MTubbin/ECE212-telemetry-tracker/hardware/ESP32_Tracker.kicad_pcb

## KiCad design hardware/ESP32_Tracker.kicad_pcb (2026-01-22)

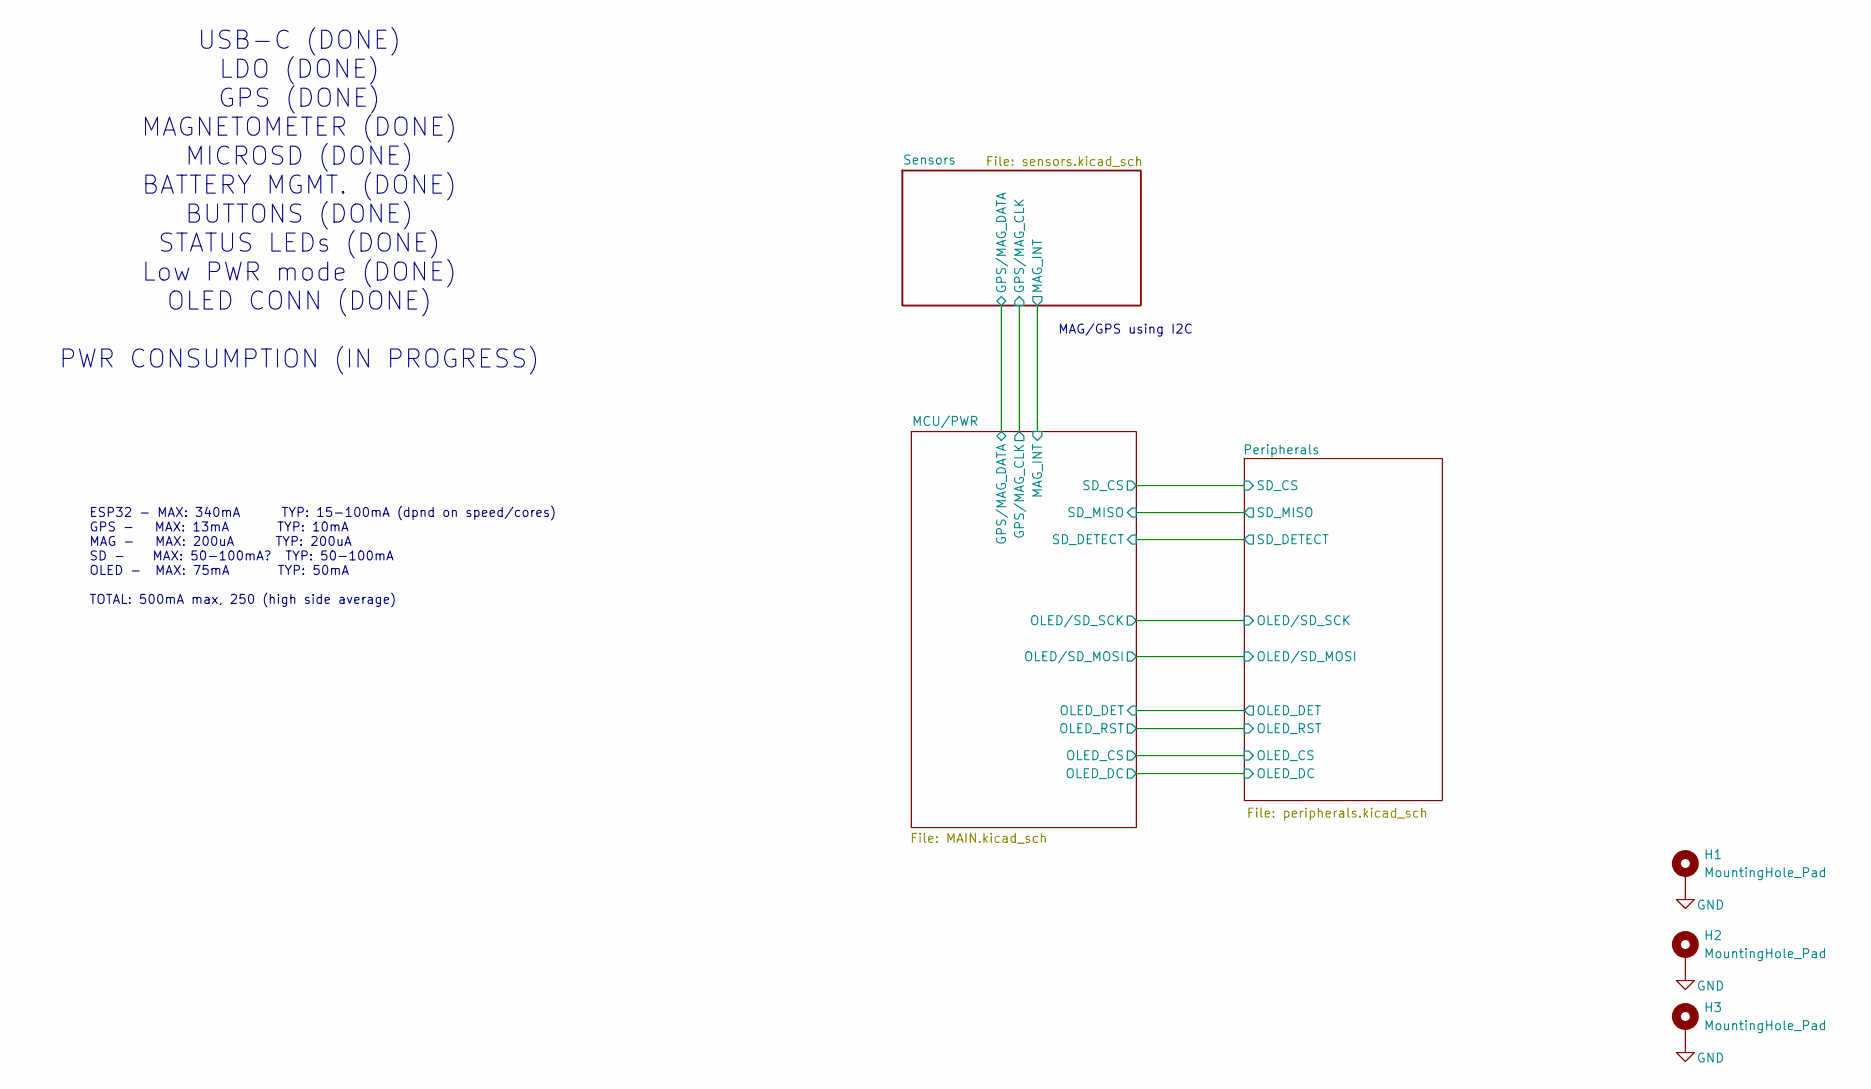
[picture p1: schematic ESP32_Tracker.kicad_sch, ESP32 Telemetry Tracker Board]

Parts:
H1, H2, H3: MountingHole_Pad; MountingHole_2.2mm_M2_Pad_Via

Connections:
GND: H1.1, H2.1, H3.1; also elsewhere on the board

Notes on the sheet:
USB-C (DONE) LDO (DONE) GPS (DONE) MAGNETOMETER (DONE) MICROSD (DONE) BATTERY MGMT. (DONE) BUTTONS (DONE) STATUS LEDs (DONE) Low PWR mode (DONE) OLED CONN (DONE) PWR CONSUMPTION (IN PROGRESS)
MAG/GPS using I2C
ESP32 - MAX: 340mA TYP: 15-100mA (dpnd on speed/cores) GPS - MAX: 13mA TYP: 10mA MAG - MAX: 200uA TYP: 200uA SD - MAX: 50-100mA? TYP: 50-100mA OLED - MAX: 75mA TYP: 50mA TOTAL: 500mA max, 250 (high side average)

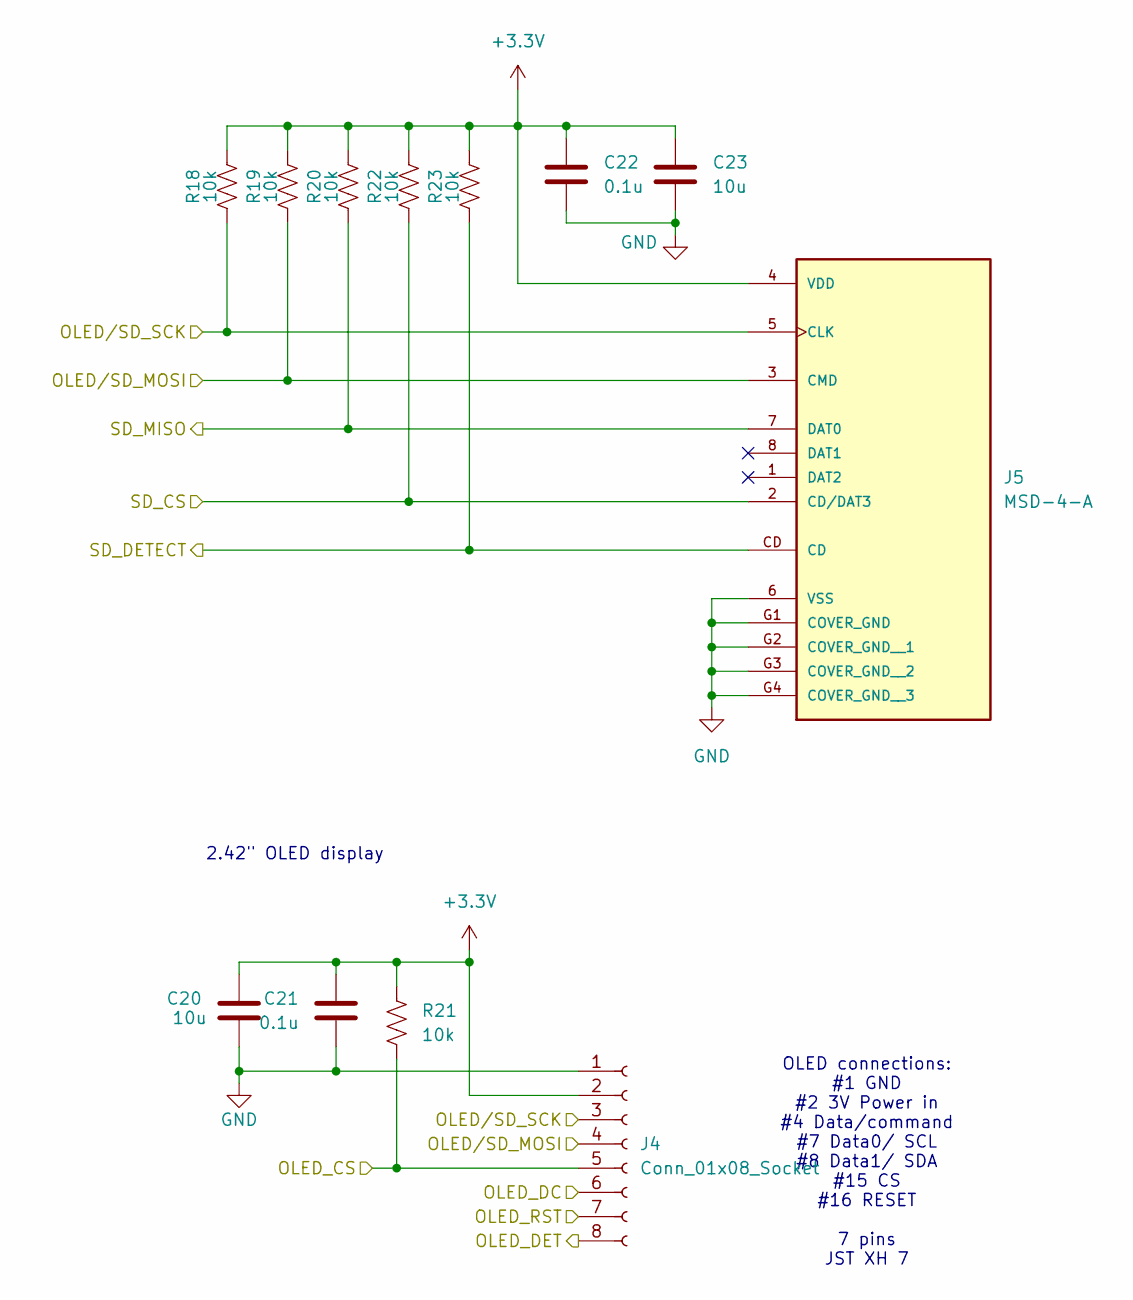
[picture p2: schematic peripherals.kicad_sch]

Parts:
C20, C23: 10u; C_0805_2012Metric; MPN CL21B106KOQNNNE; LCSC C95841
C21, C22: 0.1u; C_0805_2012Metric; MPN CL21B104KBCNNNC; LCSC C519980
J4: Conn_01x08_Socket; JST_PH_S8B-PH-K_1x08_P2.00mm_Horizontal; MPN S8B-PH-K-S
J5: MSD-4-A; CUI_MSD-4-A; PARTREV 1.0
R18, R19, R20, R21, R22, R23: 10k; R_0805_2012Metric; MPN RC0805JR-0710KL; LCSC C17414

Connections:
+3.3V: C20.2, C21.1, C22.1, C23.1, J4.2, J5.4 (VDD), R18.1, R19.1, R20.1, R21.2, R22.1, R23.1; also elsewhere on the board
/MCU/PWR/OLED_CS: J4.5, R21.1; also elsewhere on the board
/MCU/PWR/OLED_DC: J4.6; also elsewhere on the board
/MCU/PWR/OLED_DET: J4.8; also elsewhere on the board
/MCU/PWR/OLED_RST: J4.7; also elsewhere on the board
/MCU/PWR/OLED/SD_MOSI: J4.4, J5.3 (CMD), R19.2; also elsewhere on the board
/MCU/PWR/OLED/SD_SCK: J4.3, J5.5 (CLK), R18.2; also elsewhere on the board
/MCU/PWR/SD_CS: J5.2 (CD/DAT3), R22.2; also elsewhere on the board
/MCU/PWR/SD_DETECT: J5.CD, R23.2; also elsewhere on the board
/MCU/PWR/SD_MISO: J5.7 (DAT0), R20.2; also elsewhere on the board
GND: C20.1, C21.2, C22.2, C23.2, J4.1, J5.6 (VSS), J5.G1 (COVER_GND), J5.G2 (COVER_GND__1), J5.G3 (COVER_GND__2), J5.G4 (COVER_GND__3); also elsewhere on the board

Notes on the sheet:
2.42" OLED display
OLED connections: #1 GND #2 3V Power in #4 Data/command #7 Data0/ SCL #8 Data1/ SDA #15 CS #16 RESET 7 pins JST XH 7

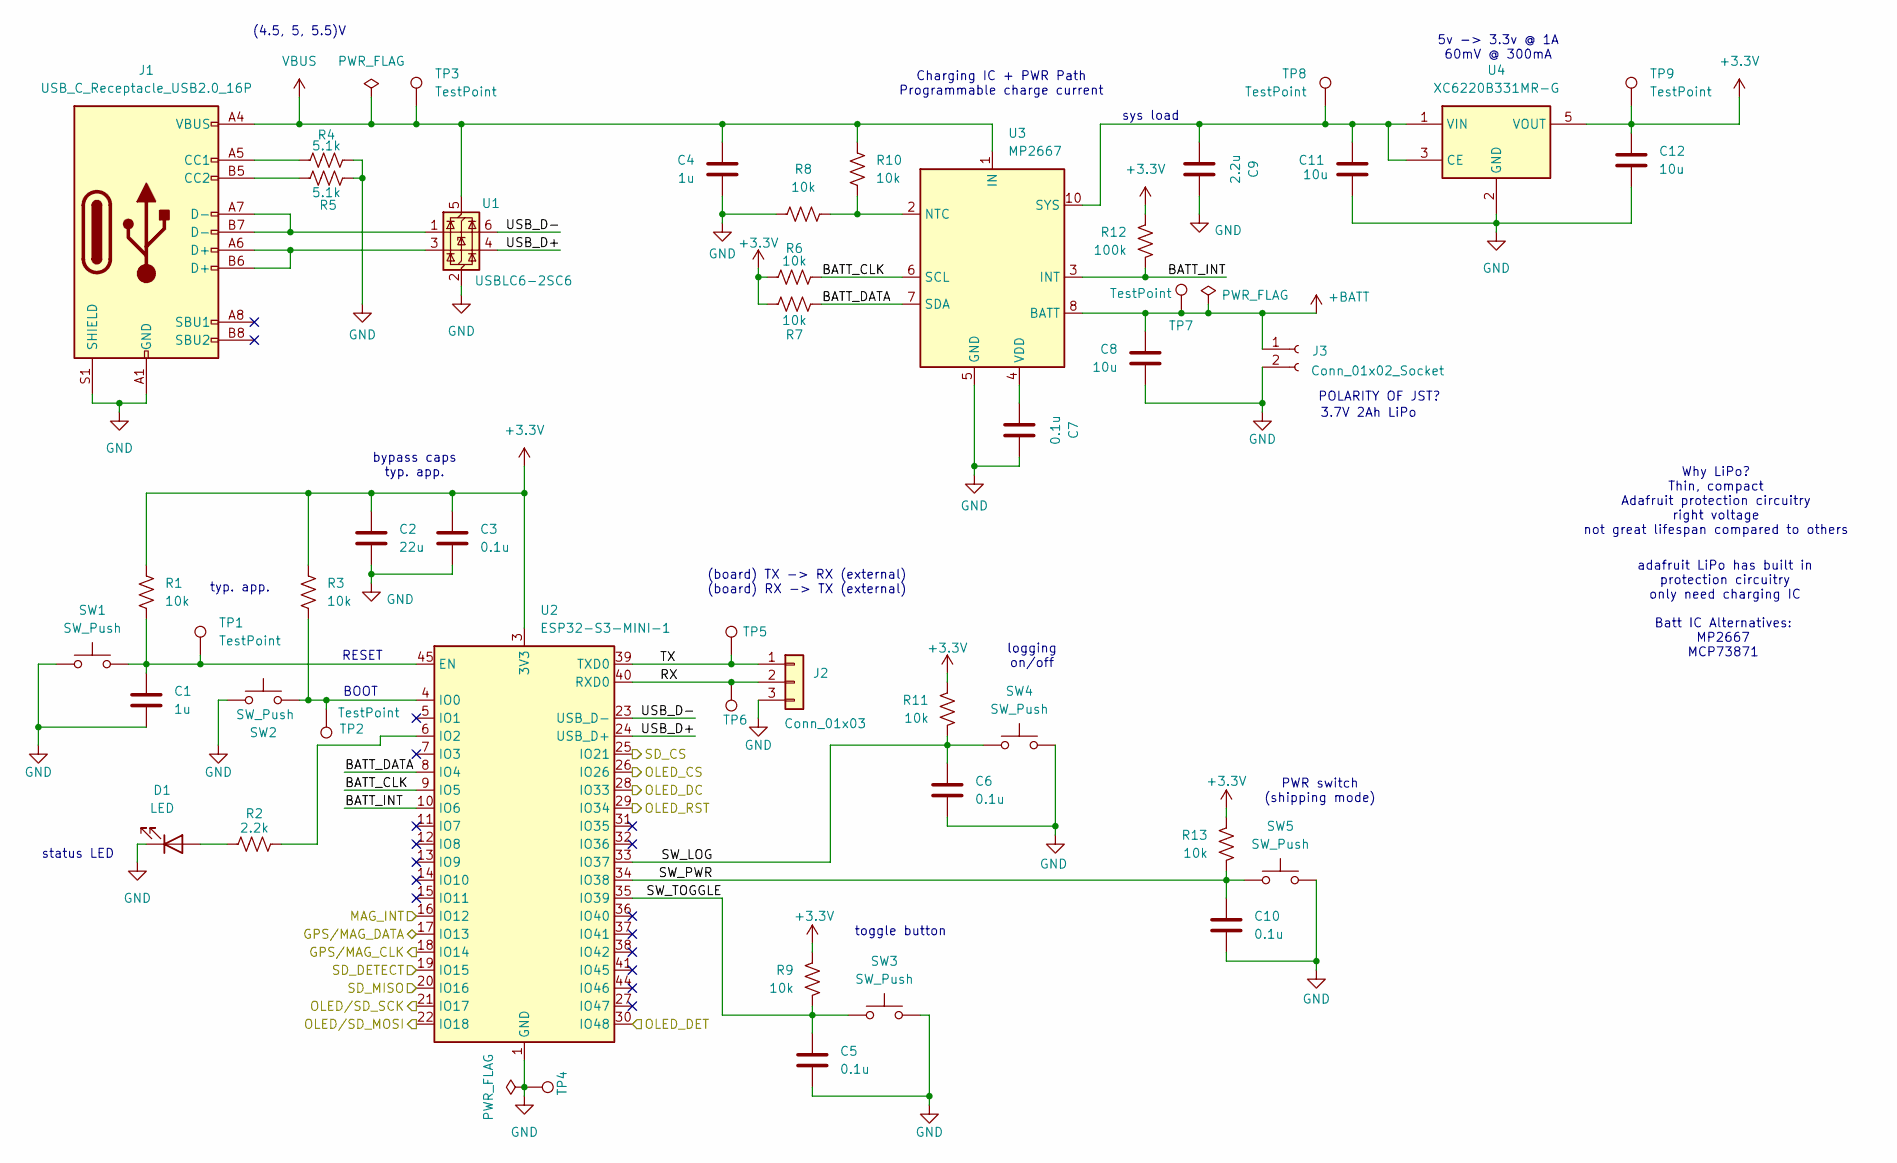
[picture p3: schematic MAIN.kicad_sch]

Parts:
C1, C4: 1u; C_0805_2012Metric; MPN CL21B105KOFNNWE; LCSC C24123
C2: 22u; C_0805_2012Metric; MPN CL21A226MOCLRNC; LCSC C98190
C3, C5, C6, C7, C10: 0.1u; C_0805_2012Metric; MPN CL21B104KBCNNNC; LCSC C519980
C8, C11, C12: 10u; C_0805_2012Metric; MPN CL21B106KOQNNNE; LCSC C95841
C9: 2.2u; C_0805_2012Metric; MPN CL21B225KOFNNNE; LCSC C28234
D1: LED; LED_0805_2012Metric; MPN LTST-C170GKT; LCSC C965812
J1: USB_C_Receptacle_USB2.0_16P; USB_C_Receptacle_GCT_USB4105-xx-A_16P_TopMnt_Horizontal; MPN USB4105-GF-A
J2: Conn_01x03; PinHeader_1x03_P2.54mm_Vertical
J3: Conn_01x02_Socket; JST_PH_S2B-PH-K_1x02_P2.00mm_Horizontal
R1, R3, R6, R7, R8, R9, R10, R11, R13: 10k; R_0805_2012Metric; MPN RC0805JR-0710KL; LCSC C17414
R2: 2.2k; R_0805_2012Metric; MPN RC0805FR-072K2L; LCSC C17520
R4, R5: 5.1k; R_0805_2012Metric; MPN RC0805JR-075K1L; LCSC C27834
R12: 100k; R_0805_2012Metric; MPN RC0805FR-07100KL; LCSC C149504
SW1, SW2: SW_Push; SW_SPST_B3U-1000P; MPN B3U-1000P; LCSC C720477
SW3, SW4, SW5: SW_Push; SW_SPST_TL3305C; MPN TL3305CF260QG
TP1, TP2, TP3, TP4, TP5, TP6, TP7, TP8, TP9: TestPoint; TestPoint_Pad_D1.5mm
U1: USBLC6-2SC6; SOT-23-6; MPN USBLC6-2SC6; LCSC C2827654
U2: ESP32-S3-MINI-1; ESP32-S2-MINI-1; MPN ESP32-S3-MINI-1-N8; LCSC C2913206
U3: MP2667; QFN-10_2MMx2MM_MNP; MPN MP2667GG-0000-Z
U4: XC6220B331MR-G; SOT-23-5; MPN XC6220B331MR-G; LCSC C86534

Connections:
+3.3V: C2.1, C3.1, C12.1, R1.2, R3.2, R6.2, R7.1, R9.2, R11.2, R12.1, R13.2, TP9.1, U2.3 (3V3), U4.5 (VOUT); also elsewhere on the board
+BATT: C8.2, J3.1, TP7.1, U3.8 (BATT), U3.9 (BATT)
/MCU/PWR/BATT_CLK: R6.1, U2.9 (IO5), U3.6 (SCL)
/MCU/PWR/BATT_DATA: R7.2, U2.8 (IO4), U3.7 (SDA)
/MCU/PWR/BATT_INT: R12.2, U2.10 (IO6), U3.3 (INT)
/MCU/PWR/GPS/MAG_CLK: U2.18 (IO14); also elsewhere on the board
/MCU/PWR/GPS/MAG_DATA: U2.17 (IO13); also elsewhere on the board
/MCU/PWR/MAG_INT: U2.16 (IO12); also elsewhere on the board
/MCU/PWR/OLED_CS: U2.26 (IO26); also elsewhere on the board
/MCU/PWR/OLED_DC: U2.28 (IO33); also elsewhere on the board
/MCU/PWR/OLED_DET: U2.30 (IO48); also elsewhere on the board
/MCU/PWR/OLED_RST: U2.29 (IO34); also elsewhere on the board
/MCU/PWR/OLED/SD_MOSI: U2.22 (IO18); also elsewhere on the board
/MCU/PWR/OLED/SD_SCK: U2.21 (IO17); also elsewhere on the board
/MCU/PWR/RX: J2.2, TP6.1, U2.40 (RXD0)
/MCU/PWR/SD_CS: U2.25 (IO21); also elsewhere on the board
/MCU/PWR/SD_DETECT: U2.19 (IO15); also elsewhere on the board
/MCU/PWR/SD_MISO: U2.20 (IO16); also elsewhere on the board
/MCU/PWR/SW_LOG: C6.1, R11.1, SW4.1, U2.33 (IO37)
/MCU/PWR/SW_PWR: C10.1, R13.1, SW5.1, U2.34 (IO38)
/MCU/PWR/SW_TOGGLE: C5.1, R9.1, SW3.2, U2.35 (IO39)
/MCU/PWR/TX: J2.1, TP5.1, U2.39 (TXD0)
/MCU/PWR/USB_D+: U1.4 (I/O2), U2.24 (USB_D+)
/MCU/PWR/USB_D-: U1.6 (I/O1), U2.23 (USB_D-)
GND: C1.2, C2.2, C3.2, C4.1, C5.2, C6.2, C7.2, C8.1, C9.2, C10.2, C11.1, C12.2, D1.1 (K), J1.A1 (GND), J1.A12 (GND), J1.B1 (GND), J1.B12 (GND), J1.S1 (SHIELD), J2.3, J3.2, R4.1, R5.2, R8.2, SW1.1, SW2.2, SW3.1, SW4.2, SW5.2, TP4.1, U1.2 (GND), U2.1 (GND), U2.2 (GND), U2.42 (GND), U2.43 (GND), U2.46 (GND), U2.47 (GND), U2.48 (GND), U2.49 (GND), U2.50 (GND), U2.51 (GND), U2.52 (GND), U2.53 (GND), U2.54 (GND), U2.55 (GND), U2.56 (GND), U2.57 (GND), U2.58 (GND), U2.59 (GND), U2.60 (GND), U2.61 (GND), U2.62 (GND), U2.63 (GND), U2.64 (GND), U2.65 (GND), U3.5 (GND), U4.2 (GND); also elsewhere on the board
unnamed: D1.2 (A), R2.2
unnamed: J1.A5 (CC1), R4.2
unnamed: J1.B5 (CC2), R5.1
unnamed: J1.A6 (D+), J1.B6 (D+), U1.3 (I/O2)
unnamed: J1.A7 (D-), J1.B7 (D-), U1.1 (I/O1)
unnamed: C1.1, R1.1, SW1.2, TP1.1, U2.45 (EN)
unnamed: R3.1, SW2.1, TP2.1, U2.4 (IO0)
unnamed: R2.1, U2.6 (IO2)
unnamed: R8.1, R10.1, U3.2 (NTC)
unnamed: C9.1, C11.2, TP8.1, U3.10 (SYS), U4.1 (VIN), U4.3 (CE)
unnamed: C7.1, U3.4 (VDD)
VBUS: C4.2, J1.A4 (VBUS), J1.A9 (VBUS), J1.B4 (VBUS), J1.B9 (VBUS), R10.2, TP3.1, U1.5 (VBUS), U3.1 (IN)

Notes on the sheet:
PWR switch (shipping mode)
BOOT
RESET
3.7V 2Ah LiPo
5v -> 3.3v @ 1A 60mV @ 300mA
Charging IC + PWR Path Programmable charge current
(4.5, 5, 5.5)V
Why LiPo? Thin, compact Adafruit protection circuitry right voltage not great lifespan compared to others
Batt IC Alternatives: MP2667 MCP73871
toggle button
logging on/off
bypass caps typ. app.
(board) TX -> RX (external) (board) RX -> TX (external)
POLARITY OF JST?
status LED
adafruit LiPo has built in protection circuitry only need charging IC
sys load
typ. app.

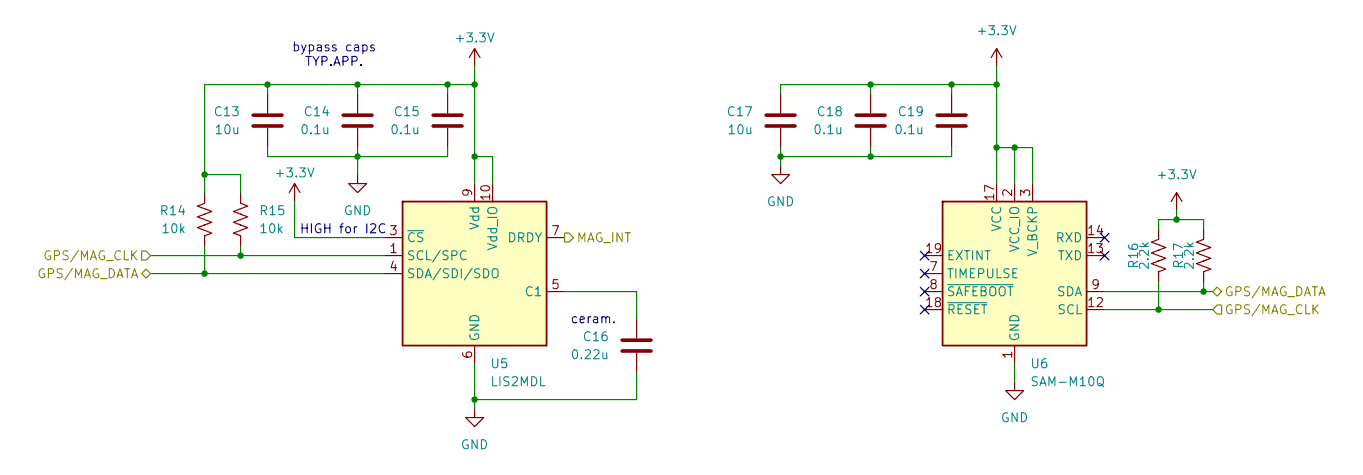
[picture p4: schematic sensors.kicad_sch]

Parts:
C13, C17: 10u; C_0805_2012Metric; MPN CL21B106KOQNNNE; LCSC C95841
C14, C15, C18, C19: 0.1u; C_0805_2012Metric; MPN CL21B104KBCNNNC; LCSC C519980
C16: 0.22u; C_0805_2012Metric; MPN CL21B224KAFNNNE; LCSC C113853
R14, R15: 10k; R_0805_2012Metric; MPN RC0805JR-0710KL; LCSC C17414
R16, R17: 2.2k; R_0805_2012Metric; MPN RC0805FR-072K2L; LCSC C17520
U5: LIS2MDL; LGA-12_2x2mm_P0.5mm; MPN LIS2MDLTR
U6: SAM-M10Q; ublox_SAM-M8Q; MPN SAM-M10Q-00B

Connections:
+3.3V: C13.1, C14.1, C15.1, C17.1, C18.1, C19.1, R14.2, R15.2, R16.2, R17.2, U5.3 (~CS), U5.9 (Vdd), U5.10 (Vdd_IO), U6.2 (VCC_IO), U6.3 (V_BCKP), U6.17 (VCC); also elsewhere on the board
/MCU/PWR/GPS/MAG_CLK: R15.1, R16.1, U5.1 (SCL/SPC), U6.12 (SCL); also elsewhere on the board
/MCU/PWR/GPS/MAG_DATA: R14.1, R17.1, U5.4 (SDA/SDI/SDO), U6.9 (SDA); also elsewhere on the board
/MCU/PWR/MAG_INT: U5.7 (DRDY); also elsewhere on the board
GND: C13.2, C14.2, C15.2, C16.2, C17.2, C18.2, C19.2, U5.6 (GND), U5.8 (GND), U6.1 (GND), U6.4 (GND), U6.5 (GND), U6.6 (GND), U6.10 (GND), U6.11 (GND), U6.15 (GND), U6.16 (GND), U6.20 (GND); also elsewhere on the board
unnamed: C16.1, U5.5 (C1)

Notes on the sheet:
ceram.
HIGH for I2C
bypass caps TYP.APP.

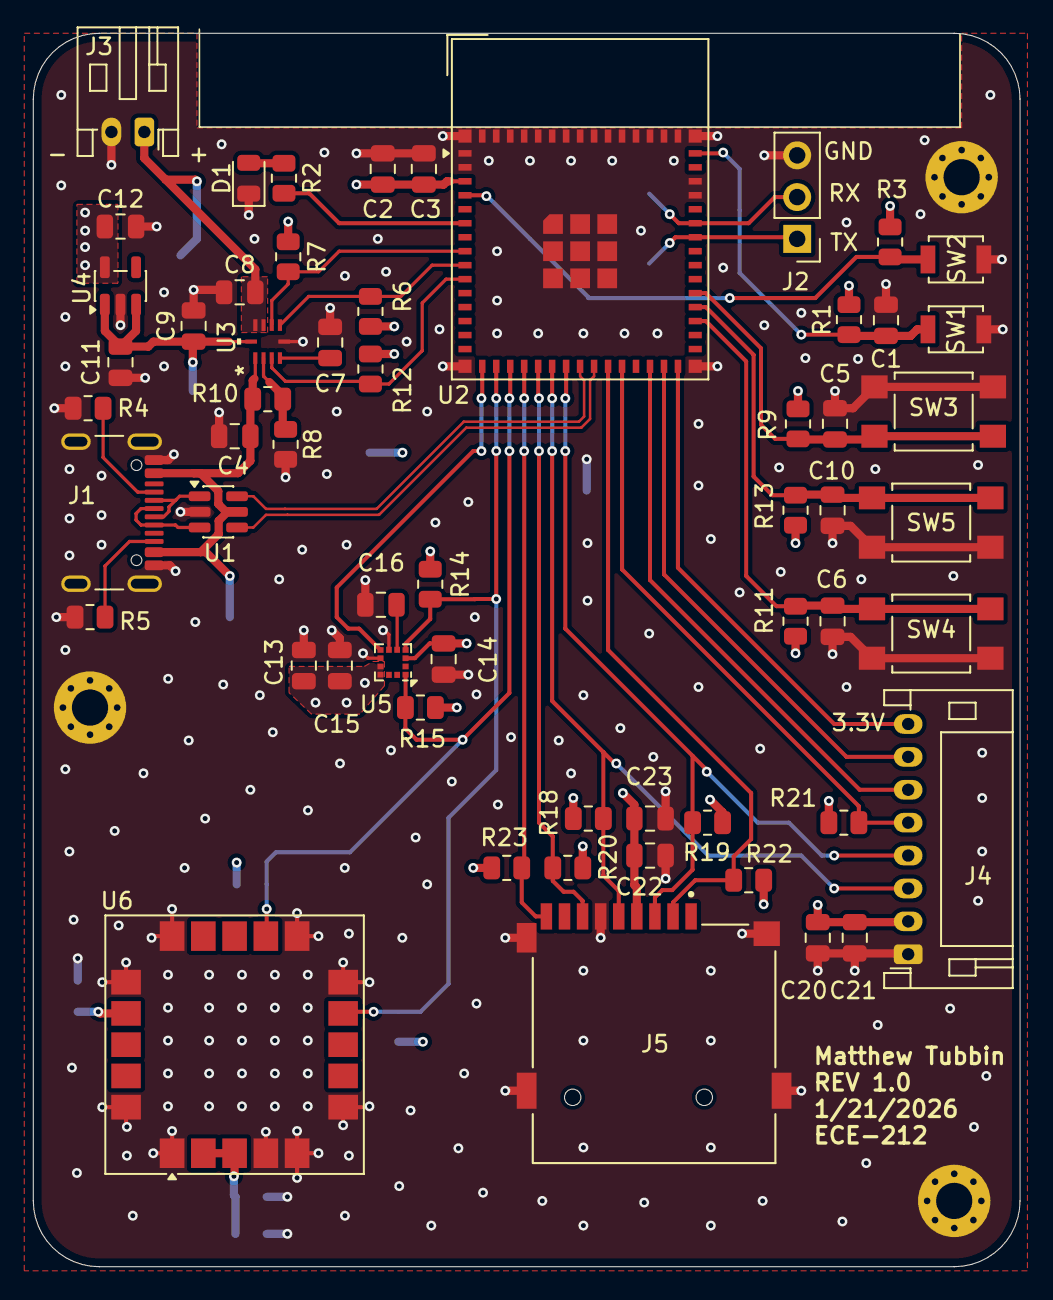
[picture p5: board ESP32_Tracker.kicad_pcb from above]

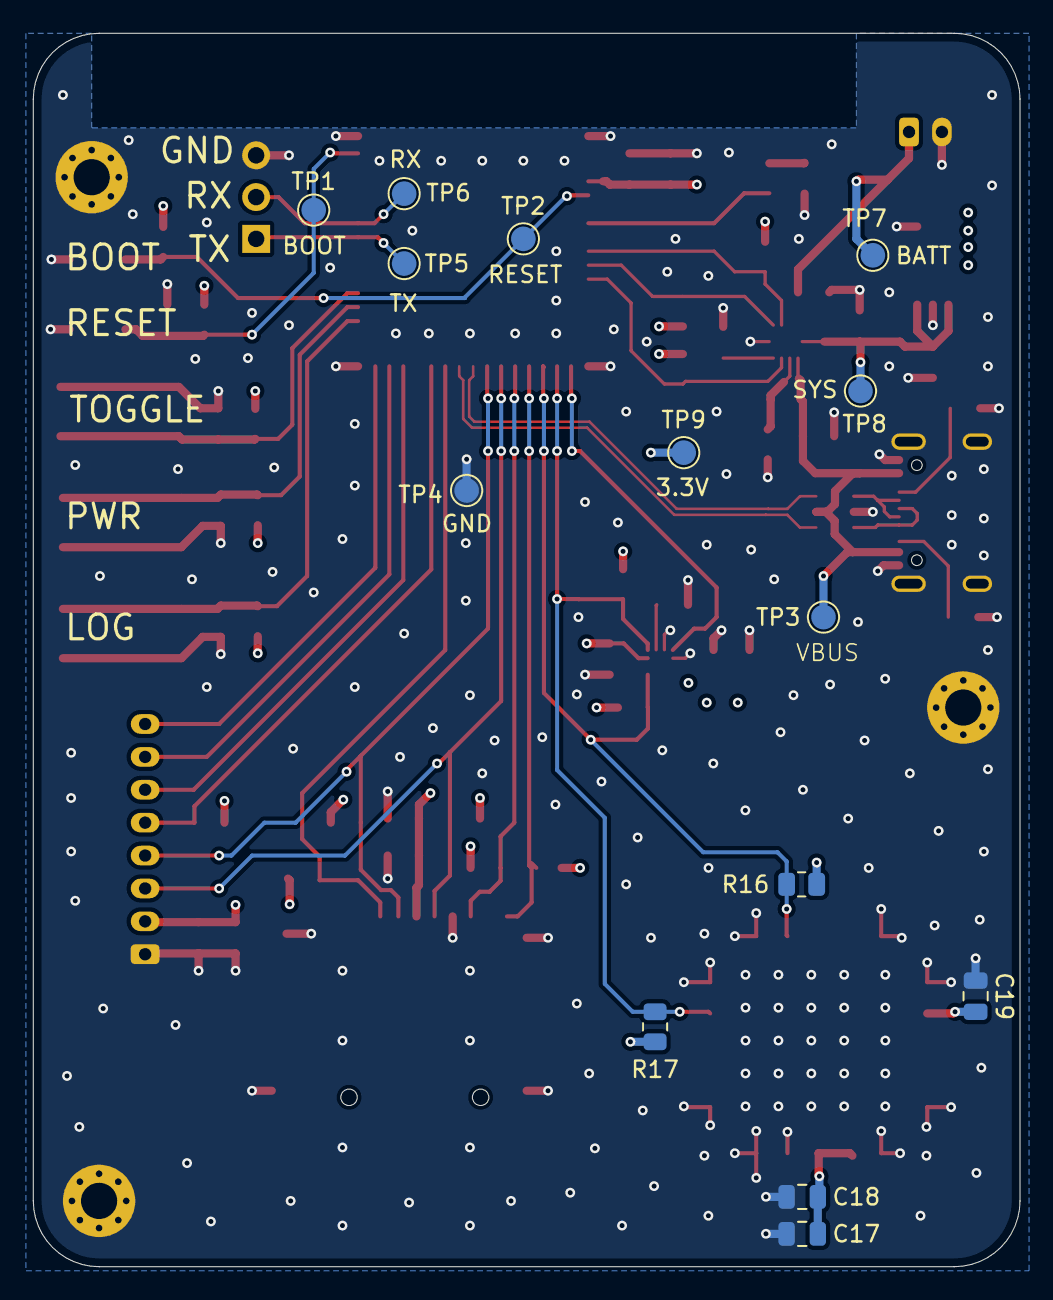
[picture p6: board ESP32_Tracker.kicad_pcb from below]

Board: 4 copper layers, 60.0 x 75.0 mm, 75 parts (14 on the bottom side), 38 nets.
