MTubbin/ECE212-telemetry-tracker/(commit log)

2026-01-07 kicad files added
    [ESP32_Tracker.kicad_pcb, ESP32_Tracker.kicad_sch]
2026-01-08 initial schematic started
    [ESP32_Tracker.kicad_sch]
2026-01-08 magnt. symbol created
    [ESP32_Tracker.kicad_sch]
2026-01-09 new magnetometer
    [ESP32_Tracker.kicad_sch]
2026-01-11 initial schematic completed
    [ESP32_Tracker.kicad_sch]
2026-01-11 MP Footprint created
    [ESP32_Tracker.kicad_sch]
2026-01-11 models added
    [ESP32_Tracker.kicad_pcb, ESP32_Tracker.kicad_sch]
2026-01-13 initial board layout completed
    [ESP32_Tracker.kicad_pcb, ESP32_Tracker.kicad_sch, MAIN.kicad_sch, peripherals.kicad_sch, sensors.kicad_sch]
2026-01-14 Layout completed
    [ESP32_Tracker.kicad_pcb, ESP32_Tracker.kicad_sch, MAIN.kicad_sch, peripherals.kicad_sch, sensors.kicad_sch]
2026-01-14 modified layout
    [ESP32_Tracker.kicad_pcb, MAIN.kicad_sch, sensors.kicad_sch]
2026-01-15 modified and labeled layout
    [ESP32_Tracker.kicad_pcb, peripherals.kicad_sch, sensors.kicad_sch]
2026-01-16 added USBC programming
    [ESP32_Tracker.kicad_pcb, MAIN.kicad_sch]
2026-01-16 modified BOM
    [ESP32_Tracker.kicad_pcb, MAIN.kicad_sch]
2026-01-16 new push button
    [MAIN.kicad_sch]
2026-01-17 modified battery terminal
    [ESP32_Tracker.kicad_pcb, MAIN.kicad_sch, sensors.kicad_sch]
2026-01-20 revised schematic
    [ESP32_Tracker.kicad_pcb, MAIN.kicad_sch]
2026-01-21 changed to 8 pin connector
    [ESP32_Tracker.kicad_pcb, ESP32_Tracker.kicad_sch, MAIN.kicad_sch, peripherals.kicad_sch]
2026-01-22 REV 1.0 Ordered
    [ESP32_Tracker.kicad_pcb, MAIN.kicad_sch, peripherals.kicad_sch, sensors.kicad_sch]
2026-02-14 organized files
    [ESP32_Tracker.kicad_pcb, ESP32_Tracker.kicad_sch, MAIN.kicad_sch, peripherals.kicad_sch, sensors.kicad_sch]
